JingYang1124/Wand-Based-on-ESP32/Pics/Wand.jpg

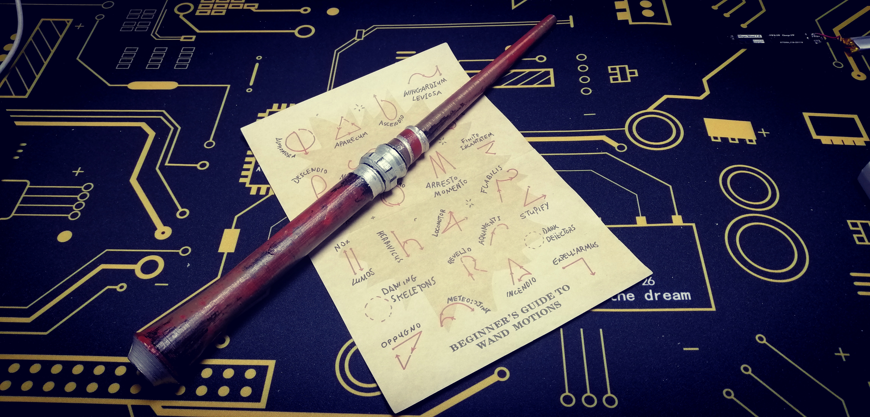
Pics/Wand.jpg
