JingYang1124/Wand-Based-on-ESP32/README.md

# Wand-Based-on-ESP32
An ESP32 based Wand that can be used to play video games
