JingYang1124/Wand-Based-on-ESP32/Hardware/Schematic.pdf

# USB-PROG

# 3V3AGPIO²¹

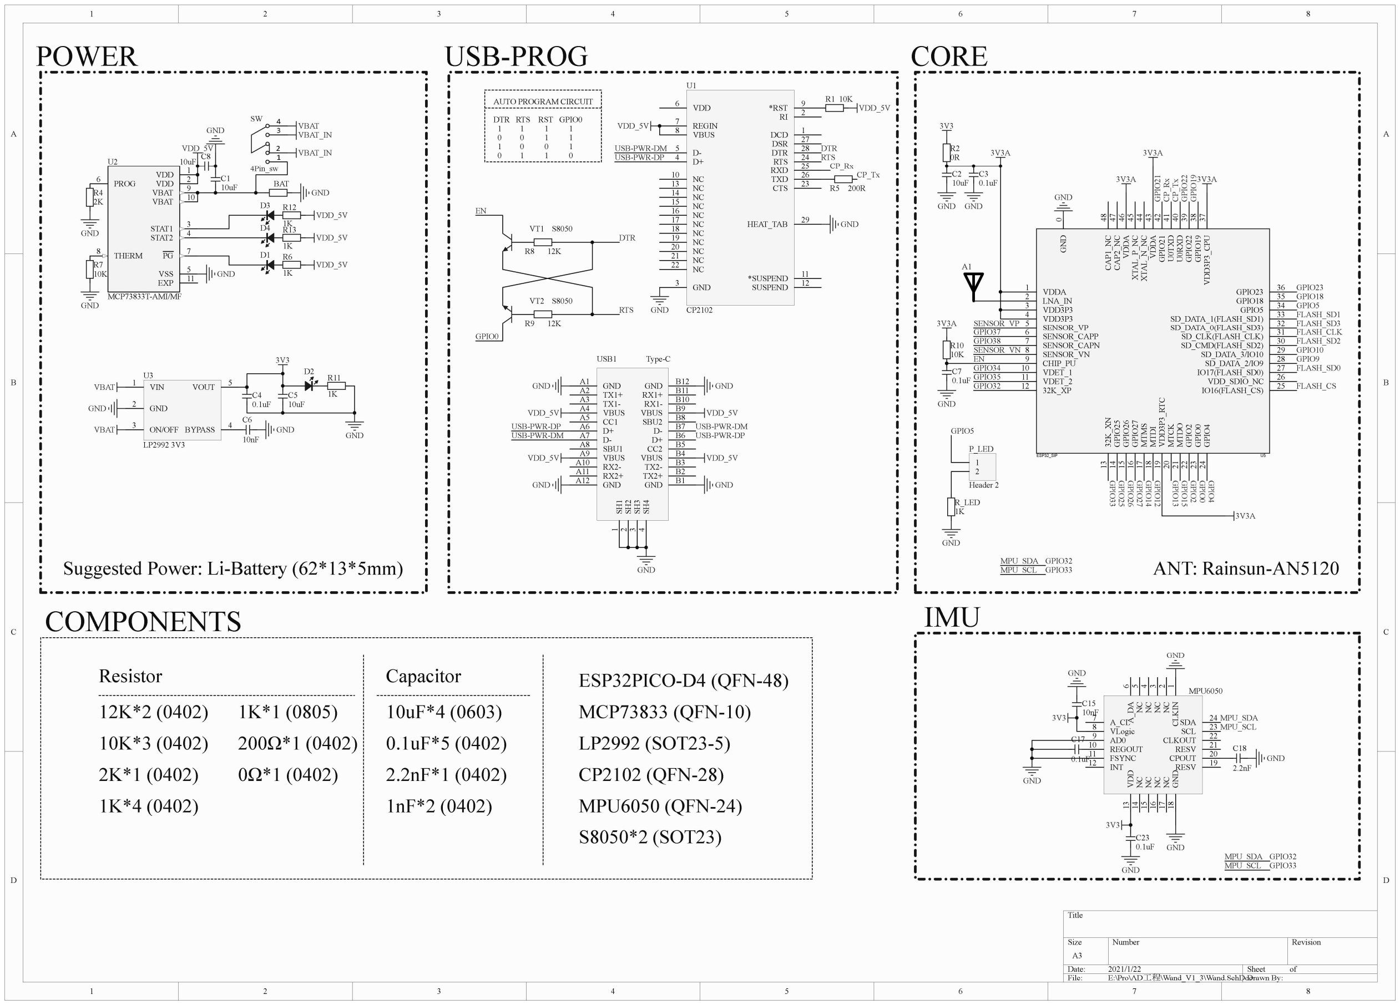
[picture p2: page 1]

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
Title

Size | Number | | Revision
A3
Date: | 2021/1/22 | Sheet | of
File: | E:\Pro\AD工程\Wand_V1_3\Wand.SchDocDrawn By:
EXP | 11 VSS | 5
PG | | 7
STAT2 | 4
STAT1 | | 3
VBAT | 10 VBAT | 9
VDD | | 2
VDD | 1

THERM 8

PROG 6

U2

MCP73833T-AMI/MF

VDD_5V

GND

GND

VDD_5V

GND

GND

GND

VBAT

EN

GPIO0

AUTO PROGRAM CIRCUIT

DTR RTS RST GPIO0
1 | 1 | 1 | 1
0 | 0 | 1 | 1
1 | 0 | 0 | 1
0 | 1 | 1 | 0

DTR

RTS GND

GND

CP_Tx

CP_Rx

VDD 6

REGIN 7
VBUS 8

D- 5
D+ 4

NC 10
NC 13
NC 14
NC 15
NC 16
NC 17
NC 18
NC 19
NC 20
NC 21
NC 22

GND 3

*RST | 9
RI | 2
DCD | 1
DSR | 27
DTR | 28
RTS | 24
RXD | 25
TXD | 26
CTS | 23
HEAT_TAB | 29
*SUSPEND | 11
SUSPEND | 12

U1

CP2102

VDD_5V

VDD_5V

USB-PWR-DM
USB-PWR-DP

DTR
RTS

USB-PWR-DM
USB-PWR-DM | USB-PWR-DP

USB-PWR-DP

GND | GND
GND | GND

GND

VDD_5V

VDD_5V

VDD_5V

VDD_5V

R4
2K

R7
10K

R6
1K
R8 | 12K
R9 | 12K

R1 10K

R5 200R

C1
10uF

GND A1
TX1+ A2
TX1- A3
VBUS A4
CC1 A5
D+ A6
D- A7
SBU1 A8
VBUS A9
RX2- A10
RX2+ A11
GND A12 | GND | B1 TX2+ | B2 TX2- | B3 VBUS | B4 CC2 | B5 D+ | B6 D- | B7 SBU2 | B8 VBUS | B9 RX1- | B10 RX1+ | B11 GND | B12 SH⁴

### 4 SH1

### 1 SH2

### 2 SH3

3

USB1 | Type-C

D1

VT2 S8050

VT1 S8050

GND

3V3

GND
GND

VBAT

VBAT

C5
10uF

C4
0.1uF
C6

10nF

POWER | CP_Rx CP_Tx

VDDA 1
LNA_IN 2
VDD3P3 3
VDD3P3 4
SENSOR_VP 5
SENSOR_CAPP 6
SENSOR_CAPN 7
SENSOR_VN 8
CHIP_PU 9
VDET_1 10
VDET_2 11
32K_XP 12 | 32K_XN 13 GPIO²⁵ 14 GPIO²⁶ 15 GPIO²⁷ 16 MTMS 17 MTDI 18 VDD³P³_RTC 19 MTCK 20 MTDO 21 GPIO² 22 GPIO⁰ 23 GPIO⁴ 24 VDD_SDIO_NC | 26
| IO16(FLASH_CS) | 25
IO17(FLASH_SD0) | 27 SD_DATA_2/IO9 | 28 SD_DATA_3/IO10 | 29 SD_CMD(FLASH_SD2) | 30 SD_CLK(FLASH_CLK) | 31 SD_DATA_0(FLASH_SD3) | 32 GND

0

SD_DATA_1(FLASH_SD1) | 33 GPIO5 | 34 GPIO18 | 35 GPIO¹⁹ ³⁸ CAP²_NC ⁴⁷ | VDDA ⁴³ XTAL_N_NC ⁴⁴ XTAL_P_NC ⁴⁵
GPIO23 | 36 U⁰TXD ⁴¹ | GPIO²² ³⁹ GPIO²¹ ⁴² | VDD³P³_CPU ³⁷ CAP¹_NC ⁴⁸ | VDDA ⁴⁶ | U⁰RXD ⁴⁰
ESP32_SIP | U5

A1

GND

3V3A GPIO²² GPIO¹⁹

GPIO23
GPIO18
GPIO5
FLASH_SD1

FLASH_SD2

FLASH_SD3

FLASH_SD0

FLASH_CLK

GPIO10
GPIO9

FLASH_CS GPIO33 GPIO25 GPIO26 GPIO27 GPIO14 GPIO12 GPIO13 GPIO15 GPIO2 GPIO0 GPIO4

GPIO32

GPIO35

GPIO34

EN

R10
10K

C7
0.1uF

GND

SENSOR_VN

SENSOR_VP
GPIO37
GPIO38

3V3A

3V3A

3V3A R2
0R

3V3

C3
0.1uF

C2
10uF

GND GND

3V3A

# CORE

MPU_SCL

MPU_SDA

GND

GND

GND

3V3

3V3

GND

GND

# GNDCLKIN

## 1 NC

## 2 NC

## 3 NC

## 4 NC

## 5 A_DA

6

A_CL 7
VLogic 8
AD0 9
REGOUT 10
FSYNC 11
INT 12 | VDD 13 NC 14 NC 15 NC 16 NC 17 GND 18 RESV | 19 CPOUT | 20 RESV | 21 CLKOUT | 22 SCL | 23 SDA | 24

MPU6050
C15
10nF

C17

0.1uF

C18

2.2nF

C23
0.1uF

# IMU

BAT

MPU_SCL

MPU_SDA
GPIO33

GPIO32

VIN 1

GND 2

ON/OFF 3

VOUT | 5
BYPASS | 4

U3

LP2992 3V3

GND

1
2

P_LED

Header 2

GPIO5

R_LED
1K

VBAT_IN

MPU_SCL

MPU_SDA
GPIO33

GPIO32

R11
1K

VDD_5V

R12
1K

D3

VDD_5V

R13
1K

D4

C8 10uF

2

3

1

### 4 SW

4Pin_sw

VBAT_IN

D2

Resistor | Capacitor
| 10uF*4 (0603) 0.1uF*5 (0402)
| 1nF*2 (0402)

2.2nF*1 (0402)

10K*3 (0402)
0Ω*1 (0402)

1K*1 (0805)

2K*1 (0402)

200Ω*1 (0402)

12K*2 (0402)

1K*4 (0402)

# CP2102 (QFN-28)

# MCP73833 (QFN-10) LP2992 (SOT23-5)

# MPU6050 (QFN-24)

# ESP32PICO-D4 (QFN-48)

# S8050*2 (SOT23)

Suggested Power: Li-Battery (62*13*5mm) | ANT: Rainsun-AN5120

# COMPONENTS
