JingYang1124/Wand-Based-on-ESP32/Pics/PCB_1.JPG

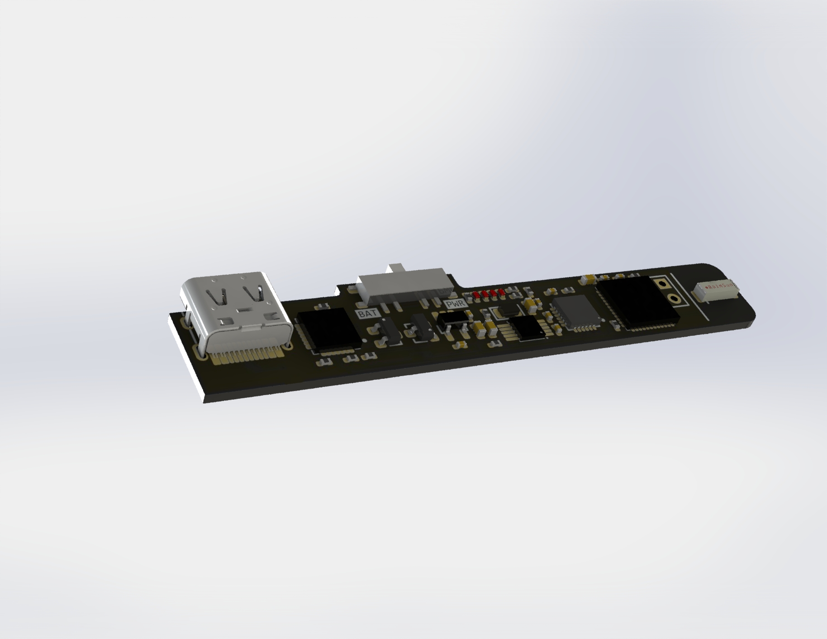
Pics/PCB_1.JPG
