JingYang1124/Wand-Based-on-ESP32/Pics/PCB_2.JPG

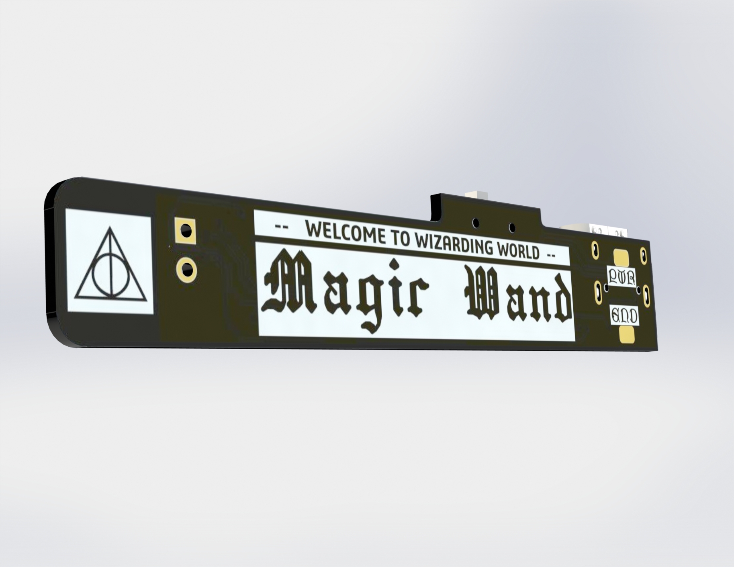
Pics/PCB_2.JPG
