JingYang1124/Wand-Based-on-ESP32/Software/Arduino_Project/Arduino IDE中的配置.png

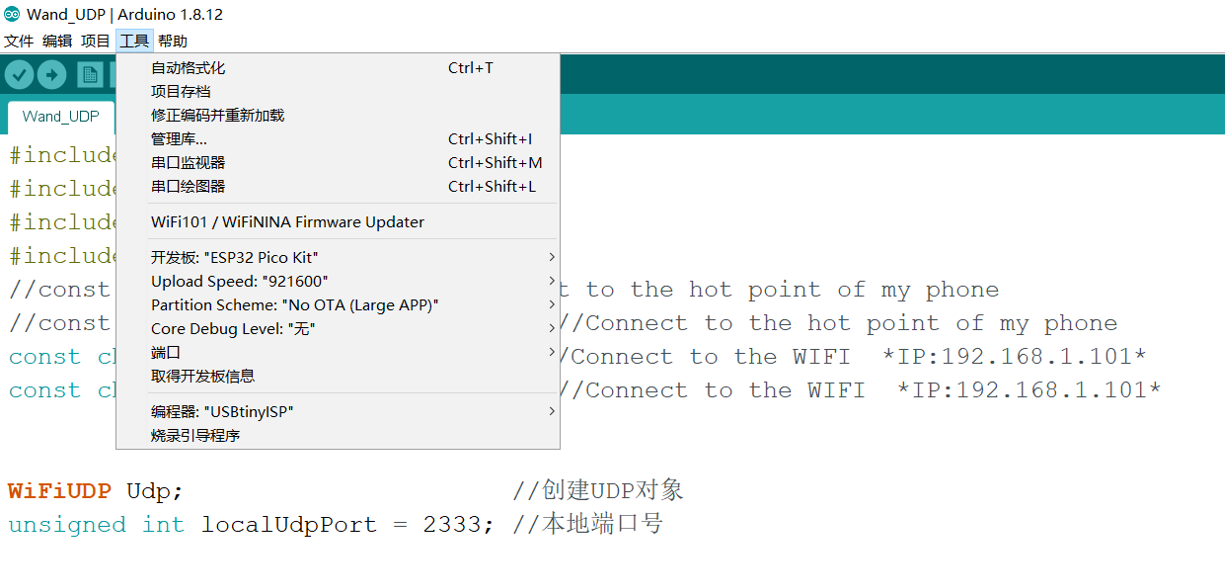
Software/Arduino_Project/Arduino IDE中的配置.png
