JingYang1124/Wand-Based-on-ESP32/Hardware/BOM_Wand_V1_3.xlsx

Comment | Description | Designator | Footprint | LibRef | Quantity | Where to buy (Just for your consideration)
RAINSUN |  | A1 | ANT-Rainsun-AN5120 | ANT-Rainsun-AP5120 | 1 | https://item.taobao.com/item.htm?spm=a1z09.2.0.0.22dc2e8dYy6cxD&id=38858253842&_u=rvcias93b7c
10uF | Capacitor | C1, C2, C5, C8 | 0603-CAP | 电容-0603 | 4 | https://detail.tmall.com/item.htm?id=13430958051&rn=a6d30e9678c71d10e7fb005d61cb5124&abbucket=17
0.1uF | Capacitor | C3, C4, C7, C17, C23 | CAP_0402 | 电容-0402 | 5 | https://detail.tmall.com/item.htm?id=567737110271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
10nF | Capacitor | C6, C15 | CAP_0402 | 电容-0402 | 2 | https://detail.tmall.com/item.htm?id=567737110271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
2.2nF | Capacitor | C18 | CAP_0402 | 电容-0402 | 1 | https://detail.tmall.com/item.htm?id=567737110271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
color red/green | LED | D1, D2, D3, D4 | LED_0402_RED | LED_0402 | 4 | https://detail.tmall.com/item.htm?id=13860351935&spm=a1z09.2.0.0.22dc2e8dYy6cxD&_u=rvcias9b73c
Header 2 | Header, 2-Pin | P_LED | HDR1X2 | Header 2 | 1 | /
10K | Resistor | R1, R7, R10 | RES_0402 | 电阻-0402 | 3 | https://detail.tmall.com/item.htm?id=567650153970&rn=23327b6e561e88b5e027e715e3e86795&abbucket=17
0R | Resistor | R2 | RES_0402 | 电阻-0402 | 1 | https://detail.tmall.com/item.htm?id=567650153970&rn=23327b6e561e88b5e027e715e3e86795&abbucket=17
BAT(1K) | Resistor | R3 | 0805-L | 电阻-0805 | 1 | https://detail.tmall.com/item.htm?id=17966575203&rn=38085c5309802936a8b17f27b56cf6ad&abbucket=17
2K | Resistor | R4 | RES_0402 | 电阻-0402 | 1 | https://detail.tmall.com/item.htm?id=575811920221&rn=23327b6e561e88b5e027e715e3e86795&abbucket=17
200R | Resistor | R5 | RES_0402 | 电阻-0402 | 1 | https://detail.tmall.com/item.htm?id=575811920221&rn=23327b6e561e88b5e027e715e3e86795&abbucket=17
12K | Resistor | R8, R9 | RES_0402 | 电阻-0402 | 2 | https://detail.tmall.com/item.htm?id=567650153970&rn=23327b6e561e88b5e027e715e3e86795&abbucket=17
1K | Resistor | R_LED, R6, R11, R12, R13 | RES_0402 | 电阻-0402 | 5 | https://detail.tmall.com/item.htm?id=575811920221&rn=23327b6e561e88b5e027e715e3e86795&abbucket=17
4Pin_sw |  | SW | 4pin_SW | 4Pin_sw | 1 | https://detail.tmall.com/item.htm?id=610239943680&_u=rvcias9d7a0&skuId=4284541744203
CP2102 | USB转TTL | U1 | QFN-28 | CP2102 | 1 | https://detail.tmall.com/item.htm?id=608339390428&spm=a1z09.2.0.0.22dc2e8dYy6cxD&_u=rvcias99141
MCP73833T-AMI/MF | Linear Charge Management Controller Li-Ion/Li-Pol 1mA 4.2V/4.35V/4.4V/4.5V 10-Pin DFN EP T/R | U2 | QFN_10_L | MCP73833T | 1 | https://item.taobao.com/item.htm?spm=a1z09.2.0.0.22dc2e8dYy6cxD&id=628056537320&_u=rvcias9db93
LP2992 3V3 | LDO | U3 | SOT23-5 | LP2992 | 1 | https://item.taobao.com/item.htm?spm=a1z09.2.0.0.22dc2e8dYy6cxD&id=619413443746&_u=rvcias91dc1
ESP32_SIP |  | U5 | QFN-48_7X7 | ESP32-PICO | 1 | https://item.taobao.com/item.htm?spm=a1z09.2.0.0.22dc2e8dYy6cxD&id=620106577640&_u=rvcias9a9fc
MPU6050 | 六轴传感器 | U8 | QFN-24 | MPU6050 | 1 | https://item.taobao.com/item.htm?spm=a1z09.2.0.0.22dc2e8dYy6cxD&id=594458638916&_u=rvcias9840b
Type-C | TYPE-C 16P 单排有孔 直插 | USB1 | Type-C-TOP | USB-Type-C-TOP | 1 | https://detail.tmall.com/item.htm?id=580366058155&spm=a1z09.2.0.0.22dc2e8dYy6cxD&_u=rvcias933ed
S8050 | Surface mount NPN transistor, package SOT-23 | VT1, VT2 | SMT_TRIODE_NPN | SMT_TRIODE_NPN | 2 | https://detail.tmall.com/item.htm?id=621537643738&ali_trackid=1_265a4a4bdee64461d781f696a860f74b
Battery | 锂电池 | 5mm*13mm*62mm |  |  | 1 | https://item.taobao.com/item.htm?spm=a1z09.2.0.0.22dc2e8dYy6cxD&id=547293284855&_u=rvcias9a7ba
