JingYang1124/Wand-Based-on-ESP32/Model/wand_part1.STL

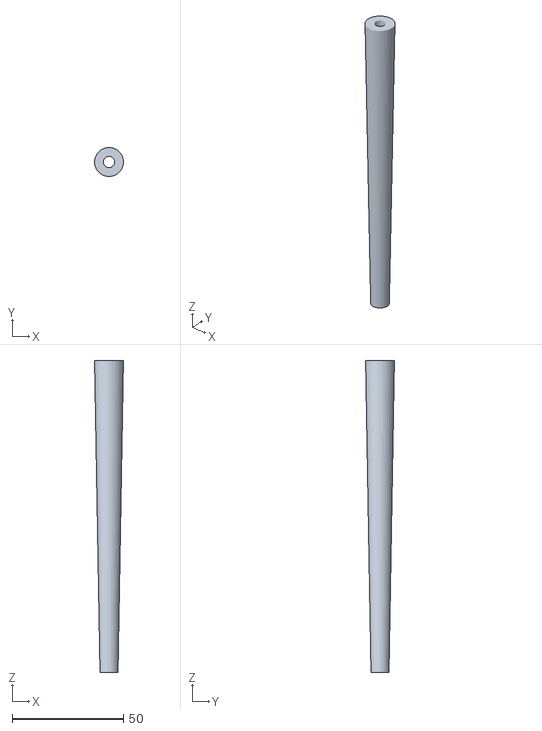
[picture p6: CAD file, 2021-02-03]
Model/wand_part1.STL
13.0 x 13.0 x 140.0
