JingYang1124/Wand-Based-on-ESP32/Model/wand_part4.STL

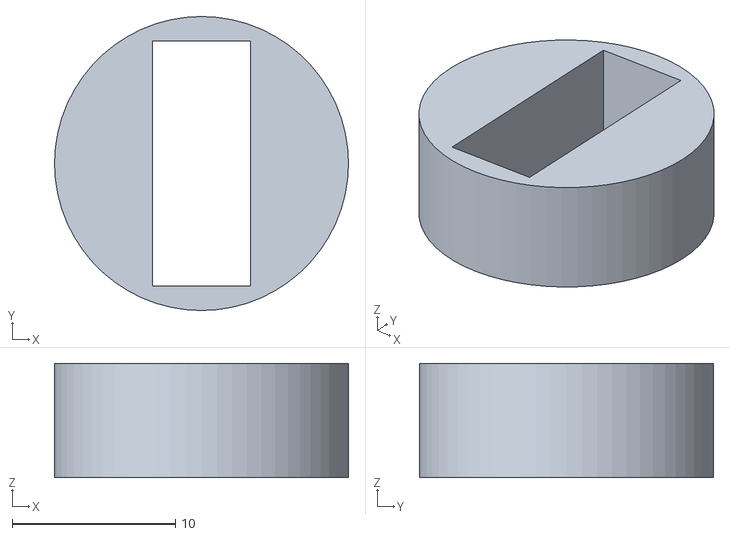
[picture p7: CAD file, 2021-02-03]
Model/wand_part4.STL
18.0 x 18.0 x 7.00
