JingYang1124/Wand-Based-on-ESP32/Model/wand_part3.STL

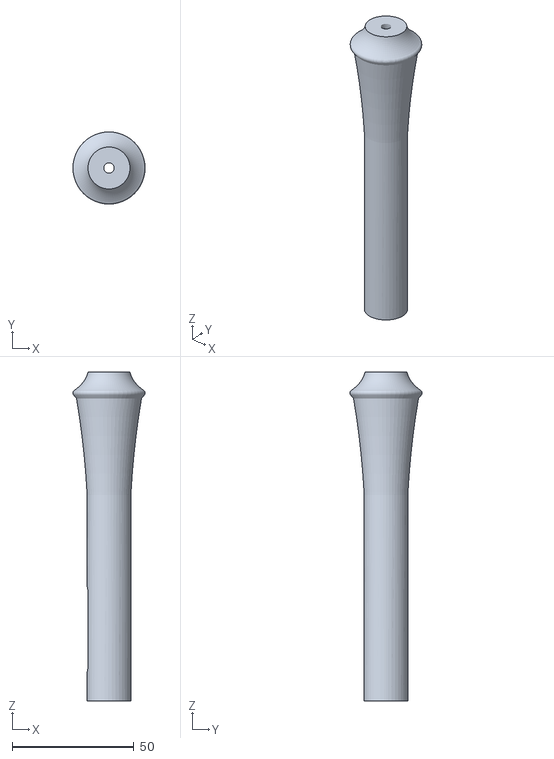
[picture p8: CAD file, 2021-02-03]
Model/wand_part3.STL
29.7 x 29.7 x 135.3
