JingYang1124/Wand-Based-on-ESP32/Model/wand_part2.STL

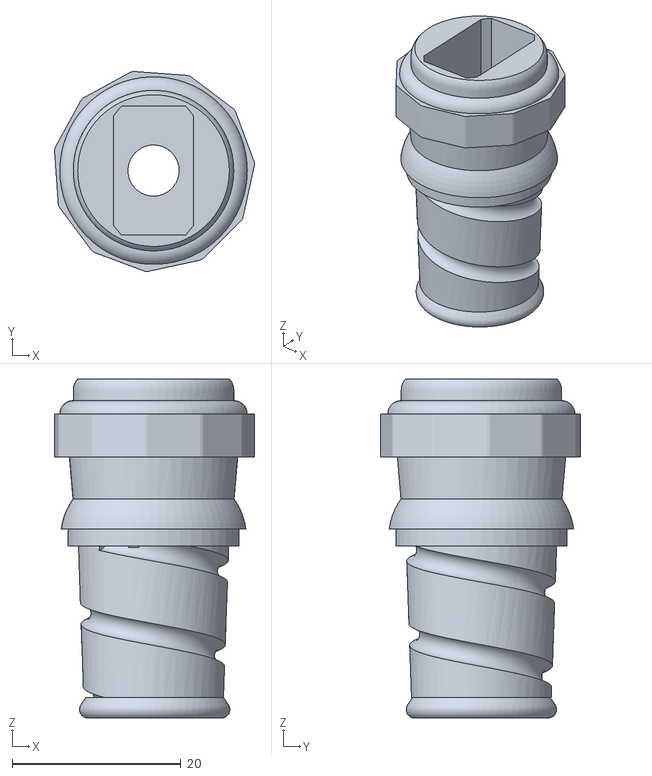
[picture p9: CAD file, 2021-02-03]
Model/wand_part2.STL
23.7 x 23.7 x 40.2
