JingYang1124/Wand-Based-on-ESP32/(list of files, drawings)

Other design files:
Hardware/PCB.PcbDoc
