JingYang1124/Wand-Based-on-ESP32/Software/Python_Scripts/1D_CNN_Trainning/Model_Compile/dataset/100test.csv

id | species | data1 | data2 | data3 | data4 | data5 | data6 | data7 | data8 | data9 | data10 | data11 | data12 | data13 | data14 | data15 | data16 | data17 | data18 | data19 | data20 | data21 | data22 | data23 | data24 | data25 | data26 | data27 | data28 | data29 | data30 | data31 | data32 | data33 | data34 | data35 | data36 | data37 | data38 | data39 | data40 | data41 | data42 | data43 | data44 | data45 | data46 | data47 | data48 | data49 | data50 | data51 | data52 | data53 | data54 | data55 | data56 | data57 | data58
101 | STUPIFY | 0.000618007 | -0.000280318 | -0.001250263 | -0.002258951 | -0.003303044 | -0.004429381 | -0.005717578 | -0.00722932 | -0.008958601 | -0.010814972 | -0.012678753 | -0.01453417 | -0.016545631 | -0.018944138 | -0.021844719 | -0.025065175 | -0.027725054 | -0.028012451 | -0.024285641 | -0.017085096 | -0.009368866 | -0.004187703 | -0.002591378 | -0.003777667 | -0.006417356 | -0.009425335 | -0.011856035 | -0.012701837 | -0.011347867 | -0.008319266 | -0.005112784 | -0.003029163 | -0.002314367 | -0.002349786 | -0.002363201 | -0.001921402 | -0.001018257 | 8.79E-05 | 0.00111863 | 0.00195171 | -0.007207182 | -0.006901652 | -0.006782109 | -0.006874345 |
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
